DrCampy/dual-VL53L0X-pic/README.md

Distance sensor using two VL53L0X time of flight sensors.

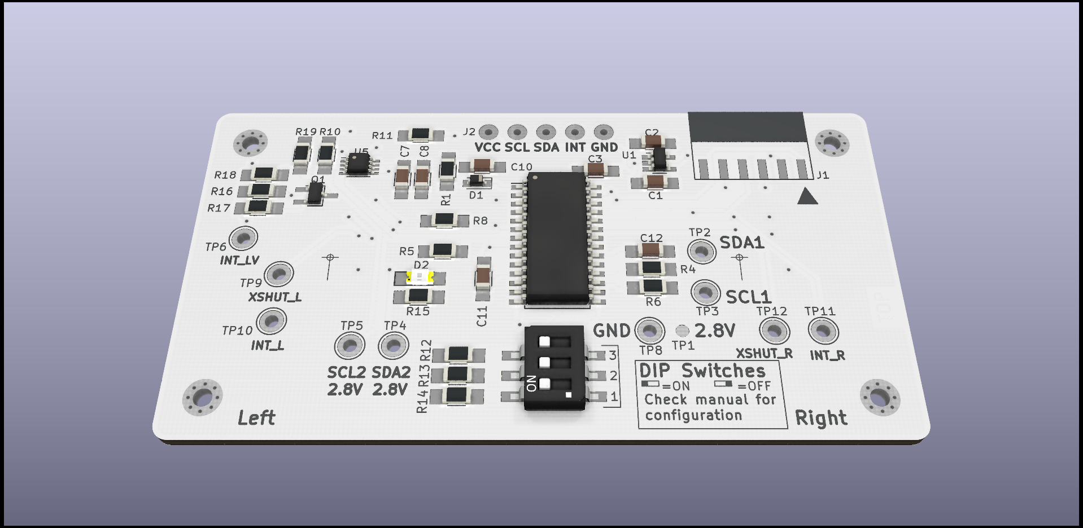
[picture p1: doc/img/V1.1/dual-vl53l0x-sensor-3d-front.png]
3D rendering of the front of the sensor

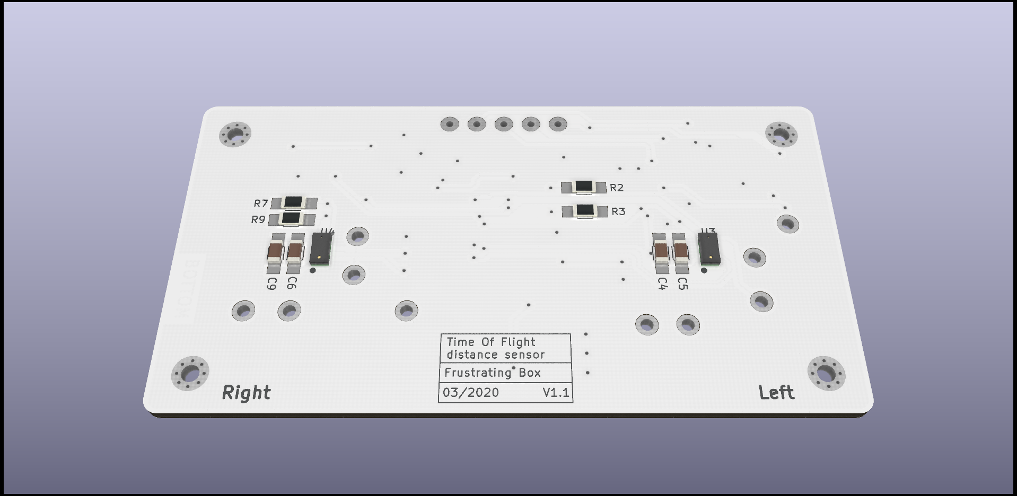
[picture p2: doc/img/V1.1/dual-vl53l0x-sensor-3d-back.png]
3D rendering of the back of the sensor
