DrCampy/dual-VL53L0X-pic/doc/tex/description.tex

\section{Introduction}
\begin{multicols}{2}
 This fully open-source sensor is a time-of-flight based distance sensor based on two VL53L0X from STMicroelectronics. It is aimed at providing accurate distance measurements at a high sampling rate which can go up to 50Hz. It is also largely configurable and offers an external interrupt functionality. It accepts a wide input voltage range and will adapt the \iic voltages and interrupt signal to the input power.
 \columnbreak
 \subsection{Features}
 \begin{itemize}
  \item Fully open-source. Adapt it to your needs
  \item Input voltage from 3.0V to 5.5V
  \item Low power consumption
  \item Distance sensing from 0 to 150 cm
  \item \iic communication bus
  \item Programmable \iic address
  \item External interrupts functionality
  \item DIP switches for boot configuration
  \item Embedded calibration routines
 \end{itemize}
\end{multicols}

\subsection{Typical application}

\begin{figure}[h]
 \centering
 
\end{figure}
