DrCampy/dual-VL53L0X-pic/doc/img/dual-vl53l0x-sensor.pdf

3.0V-5.5V

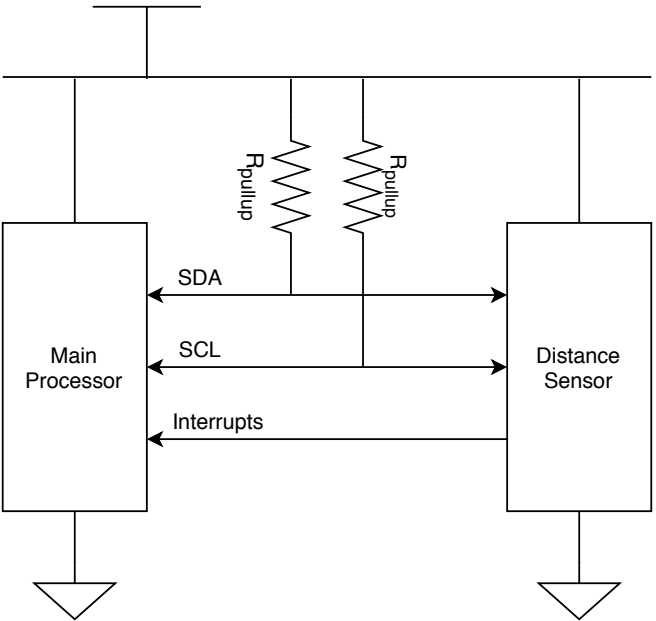
[picture p7: figure]
Main Processor; Distance Sensor; SDA; SCL; Interrupts; Rpullup
