DrCampy/dual-VL53L0X-pic/doc/tex/main.tex

\documentclass[12pt,a4paper]{article}
\usepackage[margin=0.75in]{geometry}
\usepackage[utf8]{inputenc}
\usepackage[english]{babel}
\usepackage{amsmath}
\usepackage{amsfonts}
\usepackage{amssymb}
\usepackage{caption}
\usepackage{courier}
\usepackage{fancyhdr}
\usepackage{float}
\usepackage{graphicx}
\usepackage{lastpage}
\usepackage{makecell}
\usepackage{multicol}
\usepackage{multirow}
\usepackage{pdfpages}
\usepackage{soul}
\usepackage{tabularx}
\usepackage[normalem]{ulem}
\usepackage{vhistory}
\usepackage{xcolor}
\usepackage{tikz}

\newcommand{\iic}{I\textsuperscript{2}C }
\renewcommand{\familydefault}{\sfdefault}
\renewcommand{\headrulewidth}{0pt}
\renewcommand\theadalign{bc}
\renewcommand\theadfont{\bfseries}
\renewcommand\theadgape{\Gape[4pt]}
\setlength\columnsep{30pt}

\pagestyle{fancy}
\fancyhf{}
\lhead{Hawkseye - Datasheet \vhCurrentVersion}
\lfoot{Frustrating Box}
\cfoot{\thepage / \pageref{LastPage}}
\rfoot{\vhCurrentDate}

\begin{document}

\input{title.tex}

\input{description.tex}
\pagebreak[3]

\input{layout.tex}
\pagebreak[4]

\input{interfaces.tex}
\pagebreak[3]

\input{registers.tex}
\pagebreak[3]

\input{boot_conf.tex}
\pagebreak[3]

\input{modes.tex}

\input{errors.tex}

\appendix
\newpage
\input{bill-of-material.tex}

\section{Electric Diagram}
\includepdf[pages=-, landscape]{../documents/schematicV1.1.pdf}

\begin{versionhistory}
	\vhEntry{Rev. A}{03 April 2020}{Morgan Diepart}{First release}
	\vhEntry{Rev. B}{04 April 2020}{Morgan Diepart}{Updated to PCB V1.1, added section for the measurement modes}
	\vhEntry{Rev. C}{28 April 2020}{Morgan Diepart}{Fixed typos. Added startup timing specification.}
	\vhEntry{Rev. D}{12 may 2002}{Morgan Diepart}{Fixed typos.}
\end{versionhistory}

\nocite{*}
\bibliographystyle{IEEEtran}
\bibliography{main}

\end{document}
