DrCampy/dual-VL53L0X-pic/doc/tex/title.tex

{\raggedleft 
\raisebox{-0.4\height}{}
}\hfill
%{\raggedright \hspace*{\fill} \huge Hawkseye \hspace*{\fill}}
{\raggedright  \huge Hawkseye}
\begin{center}
 {\huge{Time of flight distance sensor}}\\
 {\large\textit{Based on the VL53L0X from STMicroelectronics}}
\end{center}
\hrulefill
\par\noindent{\large \textbf{Datasheet - \vhCurrentVersion}}
