DrCampy/dual-VL53L0X-pic/doc/tex/bill-of-material.tex

\section{Bill Of Material}
\noindent
\begingroup
\begin{tabularx}{\textwidth}{|c|c|X|X|}
 \hline
 \thead{Component}               & \thead{Quantity} & \thead{PCB Locations}                  & \thead{Reference used}              \\
 \hline
 PIC24FxxGA702                   & 1                & U2                                     & PIC24FJ256GA702-I/SO                \\
 \hline
 VL53L0X                         & 2                & U3, U4                                 & VL53L0CXV0DH/1                      \\
 \hline
 2.8 LDO Regulator               & 1                & U1                                     & MIC5504-2.8YM5-TR                   \\
 \hline
 \iic Voltage Translator         & 1                & U5                                     & PCA9306DCTR                         \\
 \hline
 ICSP Header [Optional]          & 1                & J1                                     & 10129380-906001ALF                  \\
 \hline
 Canal N Ench. MOSFET          & 1                & Q1                                     & 2N7002K-7                             \footnote{On PCB V1.0 a P Mosfet is used. That part of the circuit was badly designed and PCB V1.0 should not be used.}\\
 \hline
 DIP Switches (3)                & 1                & SW1                                    & 219-3LPS                            \\
 \hline
 Shottky diode                   & 1                & D1                                     & 1PS76SB10,115                       \\
 \hline
 1$\mu$F Capacitor (X5R/X7R)     & 2                & C1, C2                                 & \textit{Any 1206 package capacitor} \\
 \hline
 0.1$\mu$F Capacitor             & 6                & C3, C4, C6, C7, C10, C11               & \textit{Any 1206 package capacitor} \\
 \hline
 4.7$\mu$F Capacitor             & 3                & C5, C8, C9                             & \textit{Any 1206 package capacitor} \\
 \hline
 10$\mu$F Capacitor              & 1                & C12                                    & \textit{Any 1206 package capacitor} \\
 \hline
 \makecell{10k$\Omega$ Resistor} & 9                & R1, R2, R3, R7, R9, R12, R13, R14, R18 & \textit{Any 1206 package resistor}  \\
 \hline
 2.2k$\Omega$ Resistor           & 4                & R4, R5, R6, R8                         & \textit{Any 1206 package resistor}  \\
 \hline
 262.5k$\Omega$ Resistor         & 1                & R10                                    & \textit{Any 1206 package resistor}  \\
 \hline
 200k$\Omega$ Resistor           & 2                & R11, R16                               & \textit{Any 1206 package resistor}  \\
 \hline
 330$\Omega$ Resistor            & 3                & R15, R17, R19                          & \textit{Any 1206 package resistor}  \\
 \hline
 LED                             & 1                & D2                                     & \textit{Any 1206 package LED}       \\
 \hline
\end{tabularx}
\captionof{table}{Bill of material}
\endgroup
