DrCampy/dual-VL53L0X-pic/doc/documents/schematicV1.1.pdf

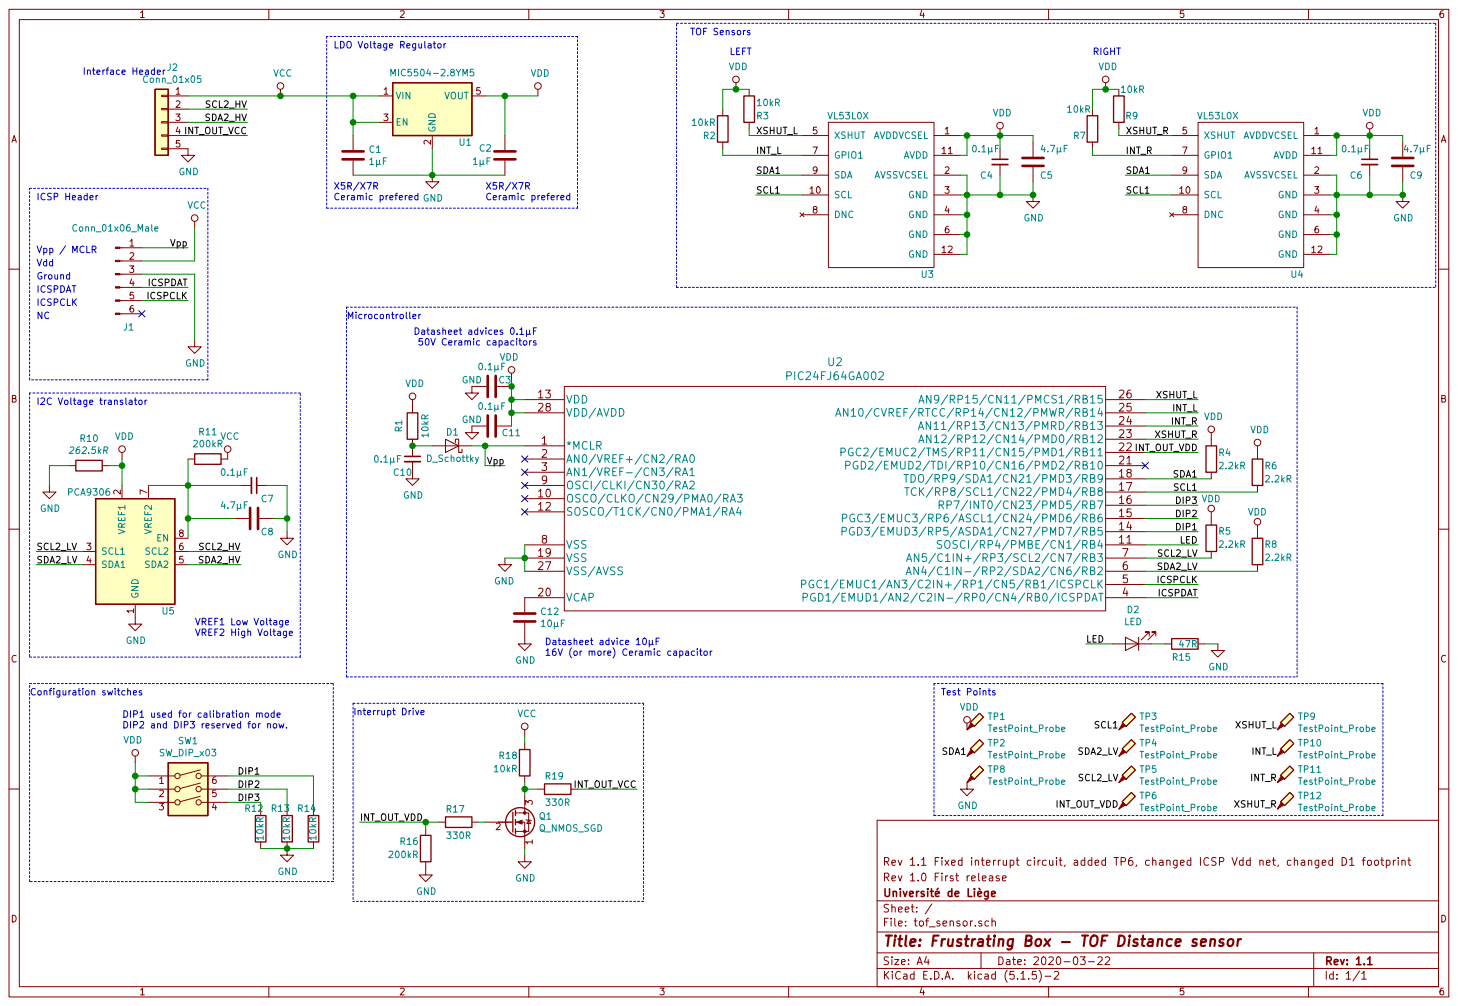
[picture p8: page 1]

TOF Sensors VREF1 Low Voltage

File: tof_sensor.sch Sheet: / Université de Liège Rev 1.0 First release Rev 1.1 Fixed interrupt circuit, added TP6, changed ICSP Vdd net, changed D1 footprint GND GND

Id: 1/1 Title: Frustrating Box - TOF Distance sensor
