DrCampy/dual-VL53L0X-pic/doc/documents/schematicV1.pdf

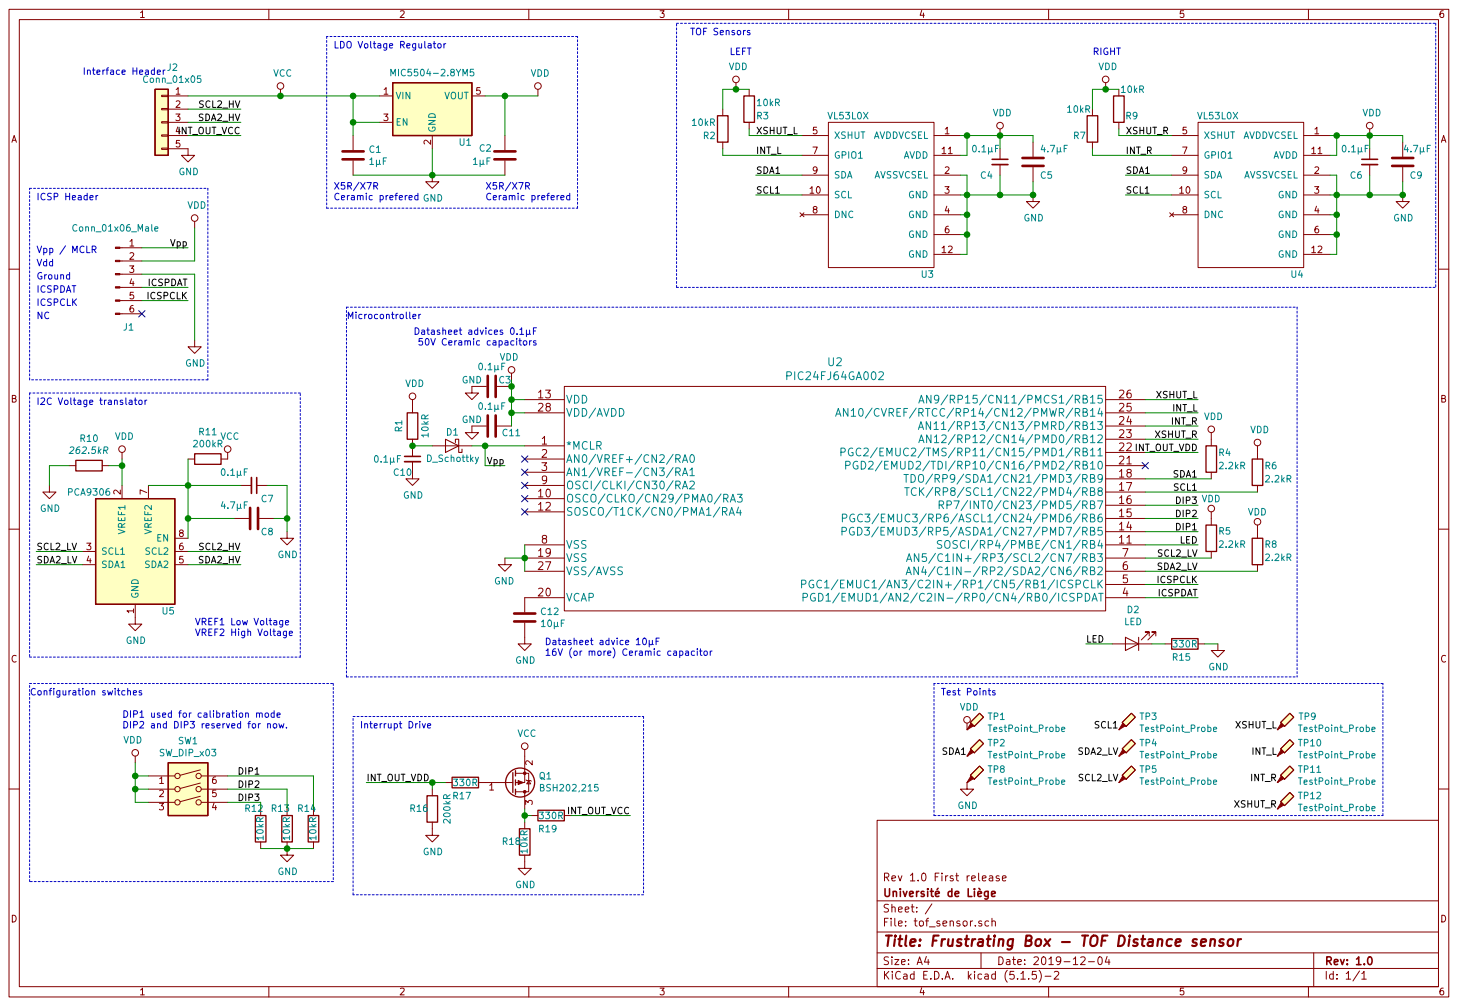
[picture p9: page 1]

16V (or more) Ceramic capacitor

File: tof_sensor.sch Sheet: / Université de Liège Rev 1.0 First release VDD

Id: 1/1 Title: Frustrating Box - TOF Distance sensor
