DrCampy/dual-VL53L0X-pic/Kicad/tof_sensor.kicad_pcb

## KiCad design Kicad/tof_sensor.kicad_pcb (2021-03-09)

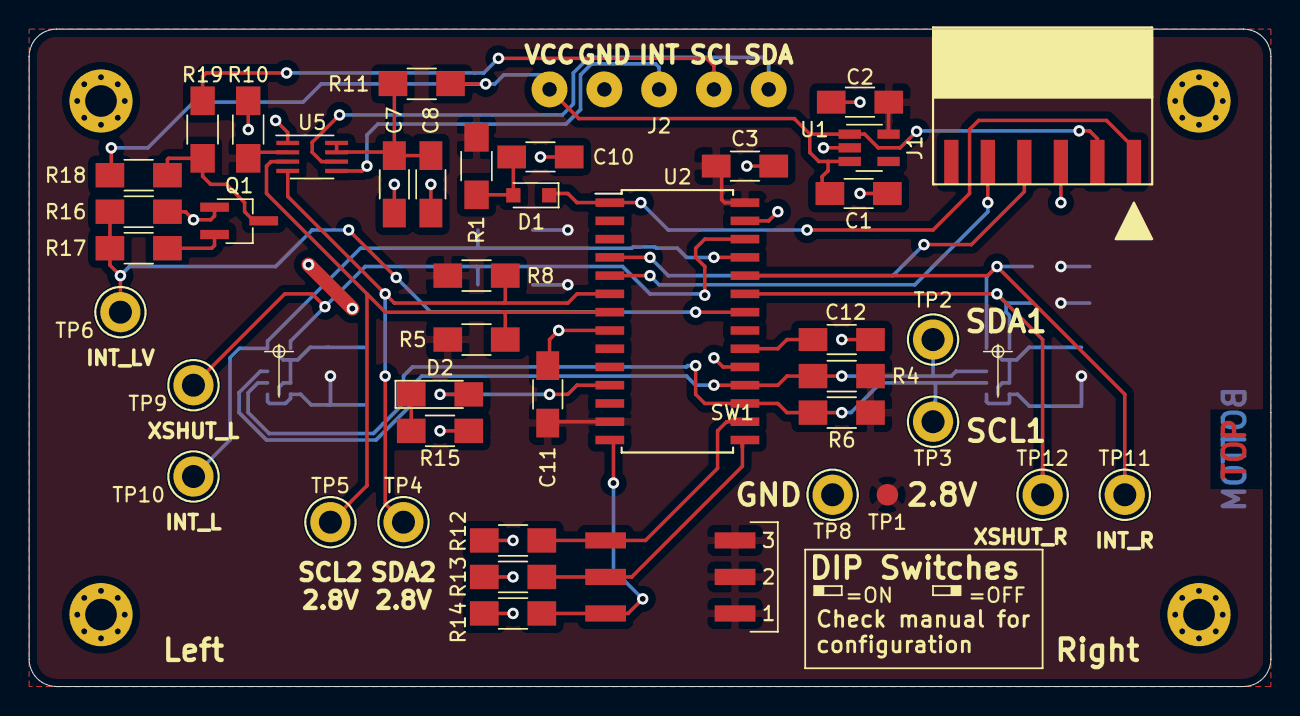
[picture p10: board tof_sensor.kicad_pcb from above]

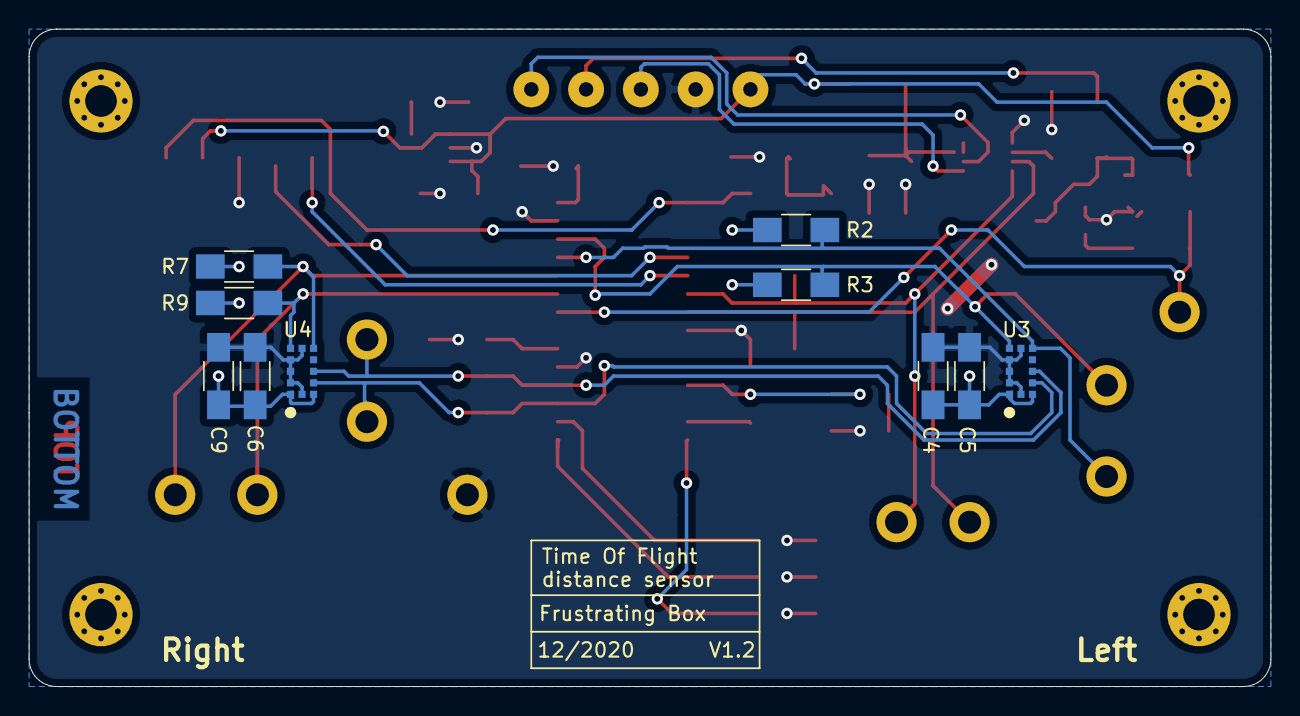
[picture p11: board tof_sensor.kicad_pcb from below]

Board: 2 copper layers, 86.4 x 45.7 mm, 53 parts (10 on the bottom side), 28 nets.

Parts:
C1, C2: 1µF; C_1206_HandSoldering
C3, C4, C6, C7, C10, C11: 0.1µF; C_1206_HandSoldering
C5, C8, C9: 4.7µF; C_1206_HandSoldering
C12: 10µF; C_1206_HandSoldering
D1: D_Schottky; D_SOD-323_HandSoldering
D2: LED; LED_1206_HandSoldering
J1: Conn_01x06_Male; Conn_01x06_2.54mm_Horizontal_SMD_Handsoldered
J2: Conn_01x05; SolderWirePad_01x05_2-5mmDrill_HandSoldering
Q1: Q_NMOS_SGD; TSOT-23_HandSoldering
R1, R2, R3, R7, R9, R12, R13, R14, R18: 10kR; R_1206_HandSoldering
R4, R5, R6, R8: 2.2kR; R_1206_HandSoldering
R10: 262.5kR; R_1206_HandSoldering
R11, R16: 200kR; R_1206_HandSoldering
R15: 47R; R_1206_HandSoldering
R17, R19: 330R; R_1206_HandSoldering
SW1: SW_DIP_x03; DIP_Switch_CTS_219_Series_Gull_Wing_HandSoldered
TP1: TestPoint_Probe; Measurement_Point_Round-SMD-Pad_Small
TP2, TP3, TP4, TP5, TP6, TP8, TP9, TP10, TP11, TP12: TestPoint_Probe; Test_Point_Keystone_5010-5014_Multipurpose
U1: MIC5504-2.8YM5; SOT-23-5_HandSoldering
U2: PIC24FJ64GA002; SOIC-28W_7.5x17.9mm_P1.27mm
U3, U4: VL53L0X
U5: PCA9306; SSOP-8_2.95x2.8mm_Pitch0.65mm

Connections:
/DIP1: R14.2, SW1.6, U2.14
/DIP2: R13.2, SW1.5, U2.15
/DIP3: R12.2, SW1.4, U2.16
/ICSPCLK: J1.5, U2.5
/ICSPDAT: J1.4, U2.4
/INT_L: R2.2, TP10.1, U2.25, U3.7
/INT_OUT_VCC: J2.4, R19.2
/INT_OUT_VDD: R16.2, R17.1, TP6.1, U2.22
/INT_R: R7.2, TP11.1, U2.24, U4.7
/LED: D2.2, U2.11
/SCL1: R6.2, TP3.1, U2.17, U3.10, U4.10
/SCL2_HV: J2.5, U5.6
/SCL2_LV: R5.1, TP5.1, U2.7, U5.3
/SDA1: R4.2, TP2.1, U2.18, U3.9, U4.9
/SDA2_HV: J2.3, U5.5
/SDA2_LV: R8.1, TP4.1, U2.6, U5.4
/Vpp: D1.1, J1.1, U2.1
/XSHUT_L: R3.2, TP9.1, U2.26, U3.5
/XSHUT_R: R9.2, TP12.1, U2.23, U4.5
GND: C1.2, C2.1, C3.1, C4.2, C5.2, C6.2, C7.1, C8.1, C9.2, C10.2, C11.1, C12.2, J1.3, J2.2, Q1.1, R10.2, R12.1, R13.1, R14.1, R15.2, R16.1, TP8.1, U1.2, U2.8, U2.19, U2.27, U3.2, U3.3, U3.4, U3.6, U3.12, U4.2, U4.3, U4.4, U4.6, U4.12, U5.1
unnamed: C7.2, C8.2, R11.2, U5.7, U5.8
unnamed: C10.1, D1.2, R1.1
unnamed: C12.1, U2.20
unnamed: D2.1, R15.1
unnamed: Q1.2, R17.2
unnamed: Q1.3, R18.1, R19.1
VCC: C1.1, J1.2, J2.1, R11.1, R18.2, U1.1, U1.3
VDD: C2.2, C3.2, C4.1, C5.1, C6.1, C9.1, C11.2, R1.2, R2.1, R3.1, R4.1, R5.2, R6.1, R7.1, R8.2, R9.1, R10.1, SW1.1, SW1.2, SW1.3, TP1.1, U1.5, U2.13, U2.28, U3.1, U3.11, U4.1, U4.11, U5.2
