DrCampy/dual-VL53L0X-pic/Code/Firmware.X/src/SlaveI2C.c

/* 
 * File:   SlaveI2C.cpp
 * Author: Morgan Diepart
 * 
 * Created on 12 janvier 2020, 00:50
 */

#include <xc.h>
#include <stdbool.h>
#include "SlaveI2C.h"
#include "sensor.h"
#include "data_storage.h"

void    I2CSlaveSetAddress          (uint8_t address);
bool    I2CSlaveIsConfigRegister    (uint8_t reg);
uint8_t I2CSlaveGetByte             ();
void    I2CSlaveSendByte            (uint8_t data);
void    I2CSlaveAck                 ();
void    I2CSlaveNack                ();
int8_t  I2CSlaveIsLowRegister       (uint8_t reg);
uint8_t I2CSlaveNextRegister        (uint8_t reg);
bool    I2CSlaveIsRegisterValid     (uint8_t reg);
uint8_t I2CSlaveGetRegister         (uint8_t address);
void    I2CSlaveSetRegister         (uint8_t address, uint8_t data);
void    I2CSlaveDistReadTrigger     ();


extern bool i2cSecondaryAddress, i2c_slave_ready;
uint8_t workingRegister = 0x00;
//extern bool L_ENflag, R_ENflag, XTALKflag, AUTO_INCflag, CONT_MODEflag, 
//        CONVflag, CONV_FINISHEDflag;

typedef enum{
    IDLE,
    WAITING_REGISTER,
    SENDING_DATA,
    RECEIVING_DATA
} State;

State   state = IDLE;

void I2CSlaveInit(uint8_t address){
    /* Sets address */
    I2CSlaveSetAddress(address);
    
    /*Automatically aknowledes our address*/
    I2C2CONHbits.AHEN = 0;
    
    /* Does NOT automatically acknowledges data bytes */
    I2C2CONHbits.DHEN = 0;
    I2C2CONLbits.STREN = 1;
    I2C2CONLbits.STRICT = 1;
    
    /* Configure pins. SCL = RB3 ; SDA = RB2*/
    ANSELBbits.ANSB2 = 0;
    ANSELBbits.ANSB3 = 0;
    
    /* Enables module */
    I2C2CONLbits.I2CEN = 1;
    
    /* Enables interrupts */
    IFS3bits.SI2C2IF = 0;
    IEC3bits.SI2C2IE = 1;

}

//If master sends NACK after we sent data, the module will not generate interrupt.
//A stop condition is expected afterwards.

void I2CSlaveExec(){
    bool isAddress = !I2C2STATbits.D_NOT_A; //It seems D_NOT_A cannot be trusted if used with debugger
    bool isRx = !I2C2STATbits.R_NOT_W;
    
    //Check for collision or so
    
    if(isAddress){//Received our address
        if(isRx){
            //we are receiving (ADD<0> = 0)
            //Next interrupt will give us some registers address
            state = WAITING_REGISTER; //update internal state

            //Clears the ReadBuffer Full flag
            char __attribute__((unused)) c = I2CSlaveGetByte();
            I2CSlaveAck();
        }else{
            //we are transmitting (ADD<0> = 1)
            //We have to send requested data.
            char __attribute__((unused)) c = I2CSlaveGetByte() ;
            state = SENDING_DATA; //update internal state
            I2CSlaveSendByte(I2CSlaveGetRegister(workingRegister)); //Transmits the requested value
            workingRegister = I2CSlaveNextRegister(workingRegister); //Selects next register.
        }
    }else{//Received / transmitted data
        if(isRx){
            /*Receiving (ADD<0> = 0)
             * First one is register, next one is data
             * If auto increment is ON, we will first receive a register then datas.
             * If auto increment is OFF we will receive a register then a data then
             * a register again and so on.
             */
            if(state == WAITING_REGISTER){
                uint8_t temp = I2CSlaveGetByte();
                if(I2CSlaveIsRegisterValid(temp)){
                    //We received the internal register the master wants to address.
                    workingRegister = temp;
                    state = RECEIVING_DATA;
                    I2CSlaveAck();
                }else{
                    I2CSlaveNack();
                }
            }else{ //Receiving data
                uint8_t data = I2CSlaveGetByte();
                I2CSlaveSetRegister(workingRegister, data);
                
                /*
                 * If autoIncrement enabled we will still be receiving data.
                 * If not we will be receiving the address of the next register
                 * to work with.
                 */
                if(CONFIG_Lbits.AUTO_INC == true){
                    workingRegister = I2CSlaveNextRegister(workingRegister);
                }else{
                    state = WAITING_REGISTER;
                }
                I2CSlaveAck(); //Acknowledges
            }
        }else{
            //Transmitting (ADD<0> = 1)
            //First byte was sent immediately after we have been addressed.
            
            //If we received NACK that means we have finished the transmission.
            if(I2C2STATbits.ACKSTAT == 0){
                //We only have to continue the transmission.
                I2CSlaveSendByte(I2CSlaveGetRegister(workingRegister));
            
                //Selects next register
                workingRegister = I2CSlaveNextRegister(workingRegister); 
            }
            
        }
    }    
}

/*
 * Updates the I2C address of the sensor. 
 * If the sensor is in secondary address mode the address used will not be used.
 * Only the address of the normal address mode can be changed.
 */
void I2CSlaveSetAddress(uint8_t address){

    /*
     * If we use the secondary i2c address mode we should not update the
     * current address, only update the address in memory
     */
    if(i2cSecondaryAddress == false){
        //Write address to I2C module
        I2C2ADD = (address>>1);
        //Update the internal value of the address.
        I2C_ADDRESSvalue = address;
    }

    //Write address to flash memory
    writeI2CSlaveAddress(&address);
}

/*
 * Returns true if the register reg is a config register.
 * Otherwise it is a data register which belongs in another "cycle"
 * and is read-only.
 */
bool I2CSlaveIsConfigRegister(uint8_t reg){
    switch(reg){
        case I2C_CONFIG_L:
        case I2C_CONFIG_H:
        case I2C_ADDRESS:
            return true;
            break;
        default:
            return false;
            break;
    }  
}

/*
 * Reads a byte from the I2C bus.
 */
uint8_t I2CSlaveGetByte(){
    return I2C2RCV;
}

/*
 * Sends the content of data on the I2C bus
 */
void I2CSlaveSendByte(uint8_t data){
    I2C2TRN = data;
    I2C2CONLbits.SCLREL = 1;
}

/*
 * Send Ack bit to transmitter
 */
void I2CSlaveAck(){
    I2C2CONLbits.ACKDT = 0; //ACK
    I2C2CONLbits.SCLREL = 1; //Release SCL
}

/*
 * Sends Nack bit to transmitter.
 */
void I2CSlaveNack(){
    I2C2CONLbits.ACKDT = 1; //NACK
    I2C2CONLbits.SCLREL = 1; //Release SCL
}

/*
 * Returns the next register starting from reg.
 * Accounts for Config/Non-config registers and auto incrementation.
 */
uint8_t I2CSlaveNextRegister(uint8_t reg){
    
    // If the register is a config register we loop accross them
    if(I2CSlaveIsConfigRegister(reg)){
        if(CONFIG_Lbits.AUTO_INC == false){
            return reg;
        }else{
            reg++;
            if(reg > I2C_ADDRESS){
                reg=I2C_CONFIG_L;
            }
        }
    }
    //If the register is a distance register we loop accross them
    else{
        if(CONFIG_Lbits.AUTO_INC == false){
            return reg;
        }else{
            reg++;
            if(reg > I2C_AVG){
                reg = I2C_RIGHT;
            }
            return reg;
        }
    }
    return 0x00;
}

/*
 * Returns true if reg is an existing register.
 * Returns false otherwise.
 */
bool I2CSlaveIsRegisterValid(uint8_t reg){
    switch(reg){
        case I2C_CONFIG_L:
        case I2C_CONFIG_H:
        case I2C_ADDRESS:
        case I2C_RIGHT:
        case I2C_LEFT:
        case I2C_MIN:
        case I2C_MAX:
        case I2C_AVG:
            return true;
            break;
        default:
            return false;
            break;
    }
}

void I2CSlaveSetRegister(uint8_t address, uint8_t data){
    switch(address){
        case I2C_CONFIG_L:
            setConfigL(data);
            break;
        case I2C_CONFIG_H:
            setConfigH(data);
            break;
        case I2C_ADDRESS:
            I2CSlaveSetAddress(data);
            break;
        default:
            /*Non-writable register*/
            break;
    }  
}

uint8_t I2CSlaveGetRegister(uint8_t address){
    switch(address){
        case I2C_CONFIG_L:
            return getConfigL();
            break;
        case I2C_CONFIG_H:
            return getConfigH();
            break;
        case I2C_ADDRESS:
            return I2C_ADDRESSvalue;
            break;
        case I2C_RIGHT:
            I2CSlaveDistReadTrigger();
            return rightDist;
            break;
        case I2C_LEFT:
            I2CSlaveDistReadTrigger();
            return leftDist;
            break;
        case I2C_MIN:
            I2CSlaveDistReadTrigger();
            return minDist;
            break;
        case I2C_MAX:
            I2CSlaveDistReadTrigger();
            return maxDist;
            break;
        case I2C_AVG:
            I2CSlaveDistReadTrigger();
            return avgDist;
            break;
        default:
            /*Unknown register*/
            break;
    }
    
    return 0;
}

/*
 *This is a trigger that gets executed whenever a distance register is
 * read by I2C.
 */
void I2CSlaveDistReadTrigger(){
    //Resets the interrupt signal in case it was raised.
    resetInt();
    CONFIG_Lbits.CONV_FINISHED = false;
}

/* Interrupt for I2C2 (slave)*/
void __attribute__((interrupt,no_auto_psv)) _SI2C2Interrupt(void){
    IFS3bits.SI2C2IF = 0; //lower interrupt flag
    
    if(!I2C2STATbits.R_NOT_W){
        i2c_slave_ready = true;
    }else{ //If we only have to respond with data, do it asap
        if(!I2C2STATbits.D_NOT_A){//Received our address
            //we are transmitting (ADD<0> = 1)
            //We have to send requested data.
            char __attribute__((unused)) c = I2CSlaveGetByte();
            state = SENDING_DATA; //update internal state
            I2CSlaveSendByte(I2CSlaveGetRegister(workingRegister)); //Transmits the requested value
            workingRegister = I2CSlaveNextRegister(workingRegister); //Selects next register.
        }else{//Received / transmitted data
            //Transmitting (ADD<0> = 1)
            //First byte was sent immediately after we have been addressed.

            //If we received NACK that means we have finished the transmission.
            if(I2C2STATbits.ACKSTAT == 0){
                //We only have to continue the transmission.
                I2CSlaveSendByte(I2CSlaveGetRegister(workingRegister));

                //Selects next register
                workingRegister = I2CSlaveNextRegister(workingRegister); 
            }
        }
    }
}
