DrCampy/dual-VL53L0X-pic/Code/Firmware.X/src/system.c

/******************************************************************************/
/* Files to Include                                                           */
/******************************************************************************/

/* Device header file */
#if defined(__XC16__)
    #include <xc.h>
#elif defined(__C30__)
    #if defined(__PIC24E__)
    	#include <p24Exxxx.h>
    #elif defined (__PIC24F__)||defined (__PIC24FK__)
	#include <p24Fxxxx.h>
    #elif defined(__PIC24H__)
	#include <p24Hxxxx.h>
    #endif
#endif

#include <stdbool.h>
#include "system.h"          /* variables/params used by system.c */
#include "sensor.h"
/******************************************************************************/
/* System Level Functions                                                     */
/*                                                                            */
/* Custom oscillator configuration funtions, reset source evaluation          */
/* functions, and other non-peripheral microcontroller initialization         */
/* functions get placed in system.c                                           */
/*                                                                            */
/******************************************************************************/

/* Refer to the device Family Reference Manual Oscillator section for
information about available oscillator configurations.  Typically
this would involve configuring the oscillator tuning register or clock
switching useing the compiler's __builtin_write_OSCCON functions.
Refer to the C Compiler for PIC24 MCUs and dsPIC DSCs User Guide in the
compiler installation directory /doc folder for documentation on the
__builtin functions. */

void ConfigureOscillator(void)
{
    //MCC generated code

    // CPDIV 1:1; PLLEN disabled; DOZE 1:8; RCDIV FRCPLL; DOZEN disabled; ROI disabled; 
    CLKDIV = 0x3100;
    // STOR disabled; STORPOL Interrupt when STOR is 1; STSIDL disabled; STLPOL Interrupt when STLOCK is 1; STLOCK disabled; STSRC SOSC; STEN disabled; TUN Center frequency;
    OSCTUN = 0x00;
    // ROEN disabled; ROSWEN disabled; ROSEL FOSC; ROOUT disabled; ROSIDL disabled; ROSLP disabled;
    REFOCONL = 0x00;
    // RODIV 0;
    REFOCONH = 0x00;
    // DCOTUN 0;
    DCOTUN = 0x00;
    // DCOFSEL 8; DCOEN disabled;
    DCOCON = 0x700;
    // DIV 0;
    OSCDIV = 0x00;
    // TRIM 0;
    OSCFDIV = 0x00;
    // AD1MD enabled; T3MD enabled; T1MD enabled; U2MD enabled; T2MD enabled; U1MD enabled; SPI2MD enabled; SPI1MD enabled; I2C1MD enabled;
    PMD1 = 0x00;
    // IC3MD enabled; OC1MD enabled; IC2MD enabled; OC2MD enabled; IC1MD enabled; OC3MD enabled;
    PMD2 = 0x00;
    // PMPMD enabled; RTCCMD enabled; CMPMD enabled; CRCMD enabled; I2C2MD enabled;
    PMD3 = 0x00;
    // CTMUMD enabled; REFOMD enabled; LVDMD enabled;
    PMD4 = 0x00;
    // CCP2MD enabled; CCP1MD enabled; CCP4MD enabled; CCP3MD enabled; CCP5MD enabled;
    PMD5 = 0x00;
    // SPI3MD enabled;
    PMD6 = 0x00;
    // DMA1MD enabled; DMA0MD enabled;
    PMD7 = 0x00;
    // CLC1MD enabled; CLC2MD enabled;
    PMD8 = 0x00;
    // CF no clock failure; NOSC FRCPLL; SOSCEN disabled; POSCEN disabled; CLKLOCK unlocked; OSWEN Switch is Complete; IOLOCK not-active;
    __builtin_write_OSCCONH((uint8_t) (0x01));
    __builtin_write_OSCCONL((uint8_t) (0x01));
    // Wait for Clock switch to occur
    while (OSCCONbits.OSWEN != 0);
    while (OSCCONbits.LOCK != 1);
}

void configureInterrupts(){

    //Configures interrupts for tof sensors
    RPINR1bits.INT2R = 13;          /* Configure pin for interrupt INT2 */
    RPINR1bits.INT3R = 14;          /* Configure pin for interrupt INT3 */
    INTCON2bits.INT2EP = 1;         /* INT2 is falling edge polarity */
    INTCON2bits.INT3EP = 1;         /* INT3 is falling edge polarity */
    ANSBbits.ANSB13 = 0;            /* Configure RB13 as digital */
    ANSBbits.ANSB14 = 0;            /* Configure RB14 as digital */
    TRISBbits.TRISB13 = 1;          /* Configure RB13 as intput */
    TRISBbits.TRISB14 = 1;          /* Configure RB14 as intput */
    
    //Configure interrupt pin for reader
    TRISBbits.TRISB11 = 0; //Configures as output
    resetInt(); //Reset int  main code execution
}
