DrCampy/dual-VL53L0X-pic/(commit log)

2019-11-07 Importing Project
    [tof_sensor.kicad_pcb, tof_sensor.sch]
2019-11-07 Updated schematic
    [tof_sensor.sch]
2019-11-07 Writing some specs for expected external I2C registers
2019-11-18 Replacing PIC16F by PIC24F16KL402
    [tof_sensor.sch]
2019-11-25 Changing PIC on schematic
    [tof_sensor.sch]
2019-12-04 Updating schematic
    Updating PIC layout, re-arranging some signals, adding an int_out line to trigger interrupt for external master.
    Adding DIP switches for configuration
    [tof_sensor.sch]
2019-12-04 Updating pin associated macros
2019-12-04 Slave I2C interrupt
2019-12-04 Writing sensors configuration code
2019-12-05 Updated Schematic [WIP]
    Added LED
    Associated components and footprints [WIP]
    [tof_sensor.sch]
2019-12-06 Footprints [WIP]
    [tof_sensor.sch]
2019-12-07 PCB Drawing [WIP]
    Mostly done. A few details remaining
    [tof_sensor-B_Cu.gbr, tof_sensor-B_Mask.gbr, tof_sensor-B_SilkS.gbr, tof_sensor-Edge_Cuts.gbr, tof_sensor-F_Cu.gbr, tof_sensor-F_Mask.gbr, tof_sensor-F_SilkS.gbr, tof_sensor-NPTH.drl]
2019-12-08 Updated PCB
    Moved sensors closer to one another
    Reduced size of PCB
    [tof_sensor-B_Cu.gbr, tof_sensor-B_Mask.gbr, tof_sensor-B_SilkS.gbr, tof_sensor-Edge_Cuts.gbr, tof_sensor-F_Cu.gbr, tof_sensor-F_Mask.gbr, tof_sensor-F_SilkS.gbr, tof_sensor-NPTH.drl]
2019-12-08 Drawing pictures and schematics
2019-12-13 Improving PCB Design
    [tof_sensor-B.Cu.gbr, tof_sensor-B.Mask.gbr, tof_sensor-B.SilkS.gbr, tof_sensor-B_Mask.gbr, tof_sensor-B_SilkS.gbr, tof_sensor-Edge.Cuts.gbr, tof_sensor-Edge_Cuts.gbr, tof_sensor-F.Cu.gbr]
2019-12-14 Interrupt Drive
    Adding an interrupt drive so it is compatible with VCC levels
    [tof_sensor.sch]
2019-12-14 Renamed PIC
    [tof_sensor.sch]
2019-12-14 Updated PCB
    Added int drive
    Added informative text
    [tof_sensor-B.Mask.gbr, tof_sensor-B.SilkS.gbr, tof_sensor-B_Cu.gbr, tof_sensor-B_Mask.gbr, tof_sensor-B_SilkS.gbr, tof_sensor-Edge.Cuts.gbr, tof_sensor-Edge_Cuts.gbr, tof_sensor-F.Cu.gbr]
2019-12-15 Ignoring fab files
    [tof_sensor-B_Cu.gbr, tof_sensor-B_Mask.gbr, tof_sensor-B_SilkS.gbr, tof_sensor-Edge_Cuts.gbr, tof_sensor-F_Cu.gbr, tof_sensor-F_Mask.gbr, tof_sensor-F_SilkS.gbr, tof_sensor-NPTH-drl_map.gbr]
2019-12-15 Updated PCB text
    [tof_sensor.kicad_pcb]
2019-12-27 Edited JLC reference text
    [tof_sensor.kicad_pcb]
2019-12-27 Added GPL logo
    [tof_sensor.kicad_pcb]
2020-01-12 Firmware [WIP]
    beginning implementation of slave I2C
2020-02-04 Slave i2c (firmware) [WIP]
2020-02-07 Slave i2c (firmware) [WIP)
2020-02-14 I2C Slave (firmware) [WIP]
2020-02-15 Added functions to make possible saving I2C slave address
2020-02-16 Updated PCB 3D models
    [tof_sensor.kicad_pcb]
2020-02-16 Added 3d renderings of the circuit
2020-02-16 Change i2c address saving functions
2020-02-16 Slave I2C (firmware)
    Slave I2C is basically finished.
    Needs debug
2020-02-16 New files for sensor specific functions
2020-02-17 Mode emun values collide with defines
    [main.c]
2020-02-17 Making sensor global variables
2020-02-18 Global variables changes fixing mistakes
    [SlaveI2C.c, main.c, sensor.c, sensor.h]
2020-02-18 Adding sensor functions [WIP]
2020-02-21 Update I2C Slave
2020-02-21 Sensors Interrupts
2020-02-22 I2C Slave fixes
    Fixed using old variable instead of global flag.
    Deleted unused functions
    [SlaveI2C.c]
2020-02-22 Add interrupts management functions and interrupt init
2020-02-24 Reading distance register resets CONV_FINISHED flag
    [SlaveI2C.c]
2020-02-24 Keyed VL53L0X footprint
    [tof_sensor.kicad_pcb]
2020-02-27 Added dual-vl53l0x-sensor.drawio
2020-02-27 Updated dual-vl53l0x-sensor.drawio
2020-02-27 Added dual-vl53l0x-sensor.svg
2020-02-27 Added dual-vl53l0x-sensor.pdf
2020-04-02 Updated bill of material
2020-04-02 Updated circuit schematic
2020-04-03 Update I2CSlaveSetAddress
    Function will not change the I2C address used in secondary address mode. It will however change the address programmed for the normal address mode.
2020-04-03 I2C debug + silicon bug
2020-04-03 Updated Oscillator configuration code
    Used Microchip MCC generated code
    [system.c]
2020-04-03 Debugged I2C writing function
    Just remember to switch analog function of SDA pin to OFF...
2020-04-03 More I2C debug
2020-04-03 VL53L0X SetAddress changes address on device
2020-04-03 I2C functions use 8 bits status instead of 32 bits
2020-04-03 Changed i2c VL53L0X_write_byte to define
    hoping to reduce the stack
2020-04-03 Disabled Brown Out Reset
    [configuration_bits.c]
2020-04-03 OSB2 pin is general purpose output
2020-04-03 I2C do not use interrupts anymore
2020-04-03 I2C1 Debug [Finished]
    I2C1 between pic and sensors now works as expected
2020-04-03 Rearranged some interrupt code
    Created interrupt configuration function in system.c
    I2C2 Init function now enables I2C2 interrupts by itself
2020-04-03 Small tweaks and fixes
    [interrupts.c, main.c, sensor.c]
2020-04-03 Fixed distance calculation bug
    [main.c]
2020-04-03 Switched I2C1 to 400kHz
2020-04-03 Enabled Brown Out Reset
    [configuration_bits.c]
2020-04-03 Updated I2C2 interrupt to respond asap with data
2020-04-03 Updated LoadCal
    perform ref calibration at the good time
2020-04-03 Fixed I2C slave not acking properly it's address
    [SlaveI2C.c]
2020-04-03 Added attributes to remove "unused variable" error at compile time
    [SlaveI2C.c]
2020-04-03 Bugfix: reversed union bitfield order
    Bitfield order was incorrect
    [sensor.h]
2020-04-03 Removed powerOnSensor / powerOffSensor functions
2020-04-03 Bugfix
    Right sensor was not woken up at initialization causing error 2.
    [main.c]
2020-04-03 Updated kicad schematic annotations
    [tof_sensor.sch]
2020-04-03 Rotated 3D model of dip switch
    [tof_sensor.kicad_pcb]
2020-04-03 Updated value of LED resistor (R15)
    [tof_sensor.sch]
2020-04-03 Updated D1 Footprint
    Changed from 1206 to SOD-323
    [tof_sensor.kicad_pcb, tof_sensor.sch]
2020-04-03 Updated PCB layout
    [tof_sensor.kicad_pcb, tof_sensor.sch]
2020-04-03 Keyed ICSP Header (J1) footprint
    [tof_sensor.kicad_pcb]
2020-04-03 Updated date on PCB
    [tof_sensor.kicad_pcb]
2020-04-03 Changed net ICSP power pin
    Changed from vdd to vcc, power now goes through the 2.8V LDO
    [tof_sensor.kicad_pcb, tof_sensor.sch]
2020-04-03 X_SHUT and INT swapped
    Were misplaced
    [tof_sensor.kicad_pcb]
2020-04-03 Changed P-MOS by N-MOS for int circuit.
    [tof_sensor.kicad_pcb, tof_sensor.sch]
2020-04-03 Updated testpoints
    [tof_sensor.kicad_pcb, tof_sensor.sch]
2020-04-03 Replaced mounting holes that went missing
    [tof_sensor.kicad_pcb]
2020-04-03 Removed JLCJLCJLCJLC text label
    [tof_sensor.kicad_pcb]
2020-04-03 Renamed sensor 3d renderings
2020-04-04 Fixed measurement not updated properly
    Measurements were not updated properly if one or both sensors were disabled
    [main.c]
2020-05-12 Created KiCad symbol for the sensor
2020-12-17 Updated board files for connector pinout
    Updated connector pinout so that reversing the connector would not create bad reverse polarity connection on the power supply of the board
    [tof_sensor.kicad_pcb, tof_sensor.sch]
2021-03-09 Switched to electrohype library
    [tof_sensor.kicad_pcb, tof_sensor.sch]
